lotzusheng543/rover-project/components, circuit,and costs/component electronic.png

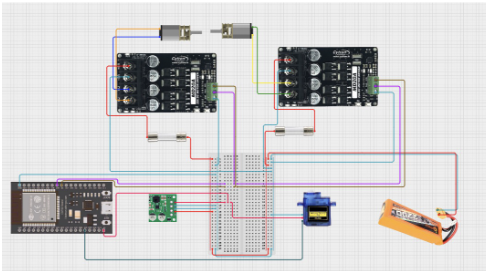
components, circuit,and costs/component electronic.png
