lotzusheng543/rover-project/components, circuit,and costs/rover circuit mar 21 2025.jpg

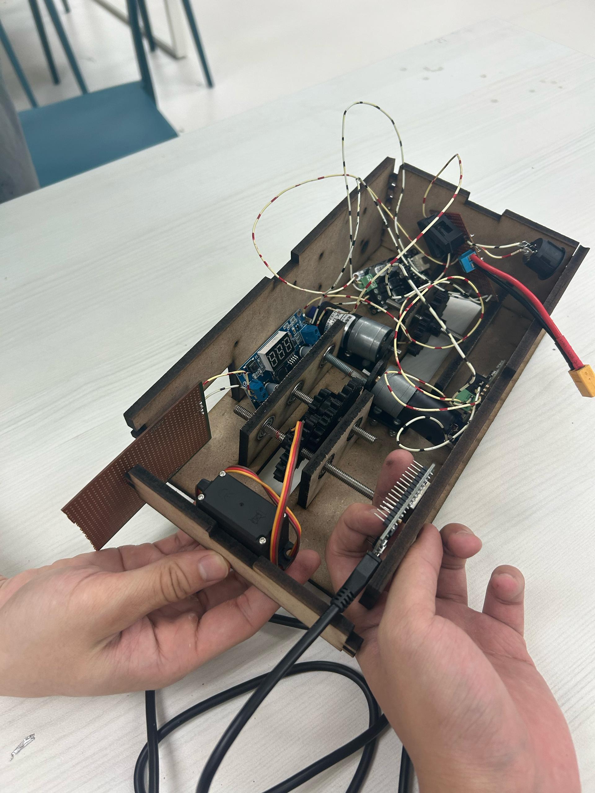
components, circuit,and costs/rover circuit mar 21 2025.jpg
