lotzusheng543/rover-project/CAD/cad drawing.jpeg

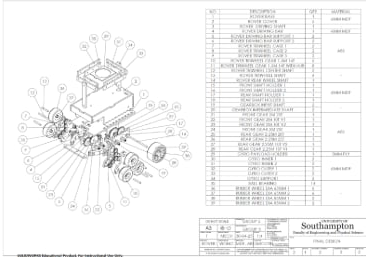
CAD/cad drawing.jpeg
