lotzusheng543/rover-project/components, circuit,and costs/ciruit design.jpeg

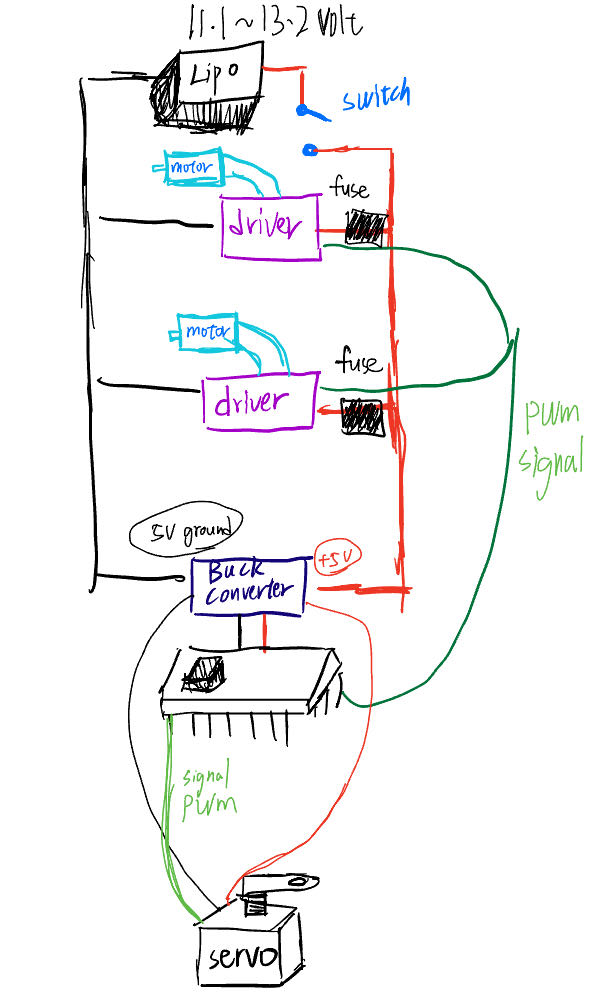
components, circuit,and costs/ciruit design.jpeg
