lotzusheng543/rover-project/components, circuit,and costs/component cost.png

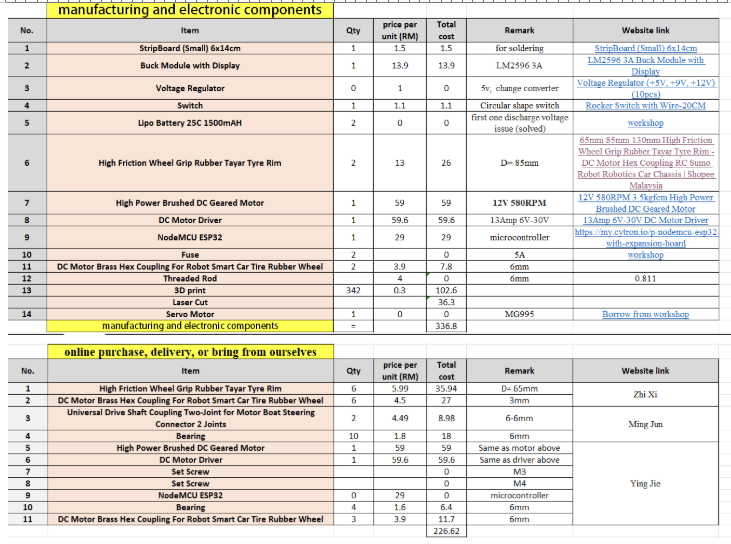
components, circuit,and costs/component cost.png
