lotzusheng543/rover-project/rover latest version coding/rover1.ino

#include <WiFi.h>
#include <ESP32Servo.h>
#include <CytronMotorDriver.h>

Servo myservo; 
int servoPin = 13;
CytronMD motor1(PWM_DIR, 21, 19);
CytronMD motor2(PWM_DIR, 33, 32);
const char* ssid = "Group5Rover";
const char* password = "12345678";
WiFiServer server(80);
int manualSpeed = 10;  // Default speed
bool isMoving = false;  // Track whether motors are moving

void setup() {
  motor1.setSpeed(0);
  motor2.setSpeed(0);
  myservo.attach(servoPin);
  myservo.write(90);
  WiFi.mode(WIFI_AP);
  WiFi.softAP(ssid, password);
  server.begin();
}



void loop() {
  WiFiClient client = server.available();

  if (client) {
    Serial.println("New Client Connected");
    String request = "";
    while (client.connected()) {
      if (client.available()) {
        char c = client.read();
        request += c;
        if (request.endsWith("\r\n\r\n")) break;
      }
    }
    Serial.println("Request: " + request);
    // Handle movement based on command
    if (request.indexOf("GET /L") != -1) {
      Serial.println("Turning Left");
      myservo.write(30);
      isMoving = true;                   // Motors are now moving
    } else if (request.indexOf("GET /R") != -1) {
      Serial.println("Turning Right");
      myservo.write(150);
      isMoving = true;                   // Motors are now moving
    } else if (request.indexOf("GET /S") != -1) {
      Serial.println("Moving Straight");
      myservo.write(90);
      isMoving = true;                   // Motors are now moving
    } else if (request.indexOf("GET /F") != -1) {
      Serial.println("Moving Forward");
      motor1.setSpeed(-manualSpeed*1.4);      // Both motors at current speed (forward or backward based on sign)
      motor2.setSpeed(-manualSpeed*2);
      isMoving = true;                   // Motors are now moving
    } else if (request.indexOf("GET /O") != -1) {
      Serial.println("Stopping");
      motor1.setSpeed(0);
      motor2.setSpeed(0);
      isMoving = false;                  // Motors are now stopped
    }else if (request.indexOf("GET /A") != -1) {
      Serial.println("Turning Right a bit");
      myservo.write(120);
      isMoving = true;                   // Motors are now moving
    } else if (request.indexOf("GET /B") != -1) {
      Serial.println("Turning Left a bit");
      myservo.write(60);
      isMoving = true;                   // Motors are now moving
    } 

    // Handle speed update
    if (request.indexOf("GET /speed?value=") != -1) {
      int idx = request.indexOf("value=") + 6;
      String valueStr = request.substring(idx);
      int endIdx = valueStr.indexOf(" ");
      if (endIdx != -1) valueStr = valueStr.substring(0, endIdx);
      int speed = valueStr.toInt();
      Serial.print("Setting speed to: ");
      Serial.println(speed);
      manualSpeed = speed;  // Store the signed speed value

      // Update motor speeds if currently moving
      if (isMoving) {
        motor1.setSpeed(-manualSpeed*1.4);
        motor2.setSpeed(-manualSpeed*2);
      }
    }
    // Send web UI
    client.println("HTTP/1.1 200 OK");
    client.println("Content-type:text/html");
    client.println("Connection: close");
    client.println();
  
    client.println("<!DOCTYPE html>");
    client.println("<html lang='en'>");
    client.println("<head>");
    client.println("  <meta charset='UTF-8' />");
    client.println("  <meta name='viewport' content='width=device-width, initial-scale=1.0'>");
    client.println("  <title>Rover Control</title>");
    client.println("  <style>");
    client.println("    body {");
    client.println("      font-family: Arial, sans-serif;");
    client.println("      text-align: center;");
    client.println("      background-color: black;");
    client.println("      color: white;");
    client.println("      margin: 0;");
    client.println("      padding: 20px;");
    client.println("    }");
    client.println("    .top-section {");
    client.println("      text-align: center;");
    client.println("      margin-bottom: 30px;");
    client.println("    }");
    client.println("    .top-section img {");
    client.println("      max-width: 150px;");
    client.println("      max-height: 150px;");
    client.println("      border-radius: 10px;");
    client.println("      background-color: white;");
    client.println("      padding: 5px;");
    client.println("    }");
    client.println("    .main-container {");
    client.println("      display: flex;");
    client.println("      justify-content: space-around;");
    client.println("      align-items: center;");
    client.println("      flex-wrap: wrap;");
    client.println("      height: 80vh;");
    client.println("    }");
    client.println("    .left-box {");
    client.println("      border: 2px solid white;");
    client.println("      padding: 50px;");
    client.println("      border-radius: 15px;");
    client.println("    }");
    client.println("    .arrow-buttons {");
    client.println("      display: flex;");
    client.println("      flex-direction: row;");
    client.println("      gap: 20px;");
    client.println("      justify-content: center;");
    client.println("      align-items: center;");
    client.println("    }");
    client.println("    .right-controls {");
    client.println("      display: flex;");
    client.println("      flex-direction: column;");
    client.println("      align-items: center;");
    client.println("      gap: 20px;");
    client.println("    }");
    client.println("    .speed-label {");
    client.println("      font-size: 20px;");
    client.println("      margin-bottom: 10px;");
    client.println("      text-decoration: underline;");
    client.println("    }");
    client.println("    .slider {");
    client.println("      width: 200px;");
    client.println("    }");
    client.println("    .button {");
    client.println("      width: 70px;");
    client.println("      height: 70px;");
    client.println("      font-size: 14px;");
    client.println("      font-weight: bold;");
    client.println("      border-radius: 8px;");
    client.println("      border: 3px solid #01f;");
    client.println("      background-color: #88f;");
    client.println("      color: white;");
    client.println("      cursor: pointer;");
    client.println("    }");
    client.println("    .button:hover {");
    client.println("      background-color: #66c;");
    client.println("    }");
    client.println("    .stop-button {");
    client.println("      background-color: red;");
    client.println("      border: 2px solid lightgreen;");
    client.println("      color: white;");
    client.println("    }");
    client.println("    .on-button {");
    client.println("      background-color: orange;");
    client.println("      border: 2px solid white;");
    client.println("      color: black;");
    client.println("    }");
    client.println("    .go-button {");
    client.println("      background-color: lightgreen;");
    client.println("      border: 2px solid white;");
    client.println("      color: black;");
    client.println("    }");
    client.println("    .stop-button:hover,");
    client.println("    .on-button:hover,");
    client.println("    .go-button:hover {");
    client.println("      opacity: 0.7;");
    client.println("    }");
    client.println("    .control-buttons {");
    client.println("      display: flex;");
    client.println("      gap: 20px;");
    client.println("    }");
    client.println("  </style>");
    client.println("</head>");
    client.println("<body>");

    // Header with Logo
    client.println("  <div class='top-section'>");
    client.println("    <p>Group 5 Rover</p>");
    client.println("    <img src='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' alt='Logo' />");
    client.println("  </div>");

    // Main Content Area
    client.println("  <div class='main-container'>");

    // Left Controls
    client.println("    <div class='left-box'>");
    client.println("      <div class='arrow-buttons'>");
    client.println("        <button class='button' onclick=\"sendCommand('L')\">←</button>");
    client.println("        <button class='button' onclick=\"sendCommand('B')\">⇐</button>");
    client.println("        <button class='button go-button' onclick=\"sendCommand('S')\">⬆</button>");
    client.println("        <button class='button' onclick=\"sendCommand('A')\">⇒</button>");
    client.println("        <button class='button' onclick=\"sendCommand('R')\">→</button>");
    client.println("      </div>");
    client.println("    </div>");

    // Right Controls
    client.println("    <div class='right-controls'>");
    client.println("      <div class='speed-label'>Speed</div>");
    client.println("      <p>Speed: <span id='speedValue'>10</span></p>");
    client.println("      <input type='range' class='slider' id='speedSlider' min='-122.5' max='122.5' value='0' oninput='updateSpeed(this.value)'>");
    
    // ✅ JavaScript for Real-Time Speed Update (Prevents Page Refresh)
    client.println("<script>");
    client.println("function sendCommand(cmd) {");
    client.println("  fetch('/' + cmd, { method: 'GET' })");
    client.println("    .then(response => console.log('Command sent:', cmd))");
    client.println("    .catch(error => console.error('Error:', error));");
    client.println("}");

    client.println("function updateSpeed(value) {");
    client.println("  document.getElementById('speedValue').innerText = value;");
    client.println("  fetch('/speed?value=' + value, { method: 'GET' })");
    client.println("    .then(response => console.log('Speed updated:', value))");
    client.println("    .catch(error => console.error('Error:', error));");
    client.println("}");
    client.println("</script>");
    client.println("      <div class='control-buttons'>");
    client.println("        <button class='button stop-button' onclick=\"sendCommand('O')\">Stop</button>");
    client.println("        <button class='button on-button' onclick=\"sendCommand('F')\">Patrol</button>");
    client.println("      </div>");
    client.println("    </div>");
    client.println("  </div>");


    delay(1);
    client.stop();
    Serial.println("Client Disconnected");
  }
}
