lotzusheng543/rover-project/(commit log)

2025-04-07 this is rover arduino coding that we use for 1st testing
2025-04-07 circuit diagram
2025-04-07 with the arduino wifiaccess point
2025-05-08 add the circuit design, component selected
